petermcd1010/rhino_3d_models/arduino_base_xr2_xr2_unmounted.png

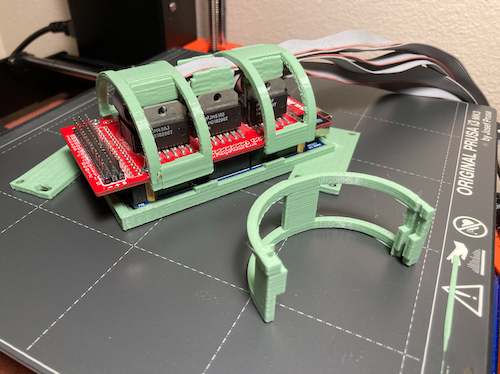
arduino_base_xr2_xr2_unmounted.png
