petermcd1010/rhino_3d_models/arduino_base_xr3_mounted.png

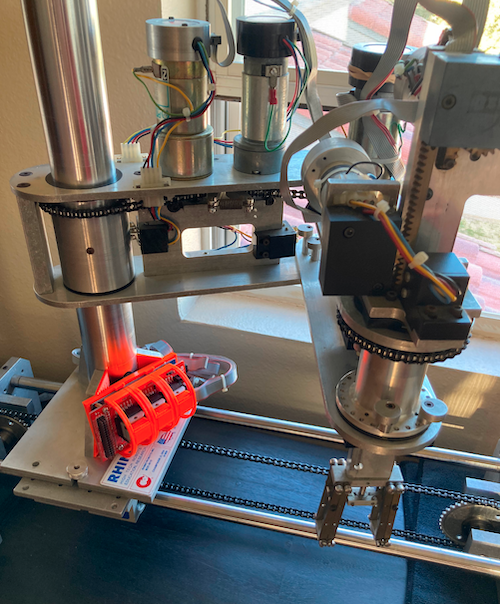
arduino_base_xr3_mounted.png
