petermcd1010/rhino_3d_models/rpi4_base_scara_with_tpu.stl

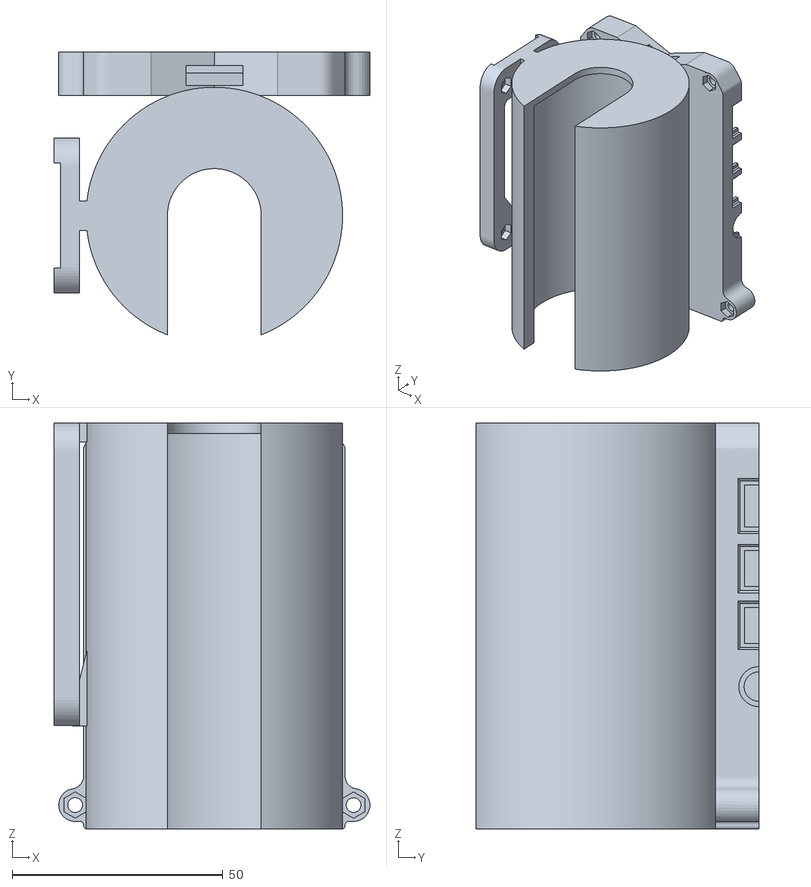
[picture p35: CAD file, 2023-12-21]
rpi4_base_scara_with_tpu.stl
74.9 x 67.0 x 96.2
