petermcd1010/rhino_3d_models/realsense_rhino_mount_plate_scara.stl

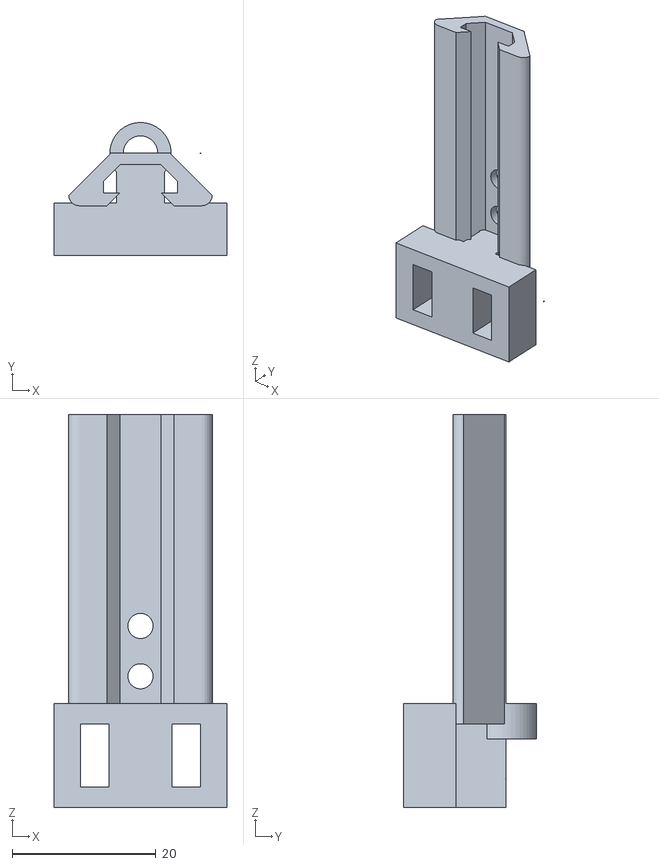
[picture p36: CAD file, 2023-12-14]
realsense_rhino_mount_plate_scara.stl
24.0 x 18.5 x 54.7
