petermcd1010/rhino_3d_models/realsense_rhino_mount_plate_xr1_spacer_plate.stl

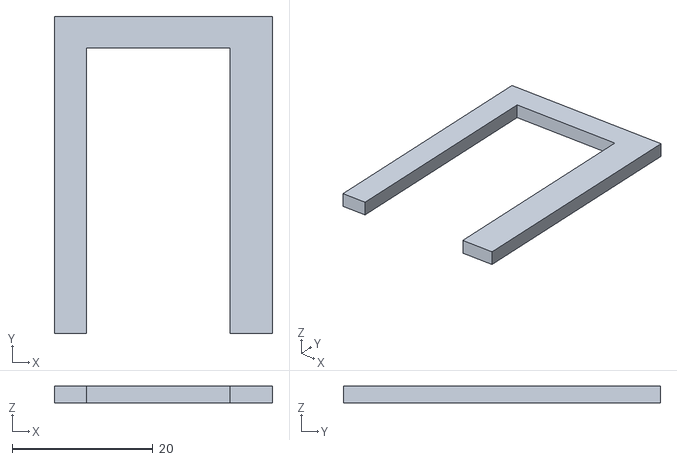
[picture p37: CAD file, 2023-11-25]
realsense_rhino_mount_plate_xr1_spacer_plate.stl
31.0 x 45.0 x 2.40
