petermcd1010/rhino_3d_models/realsense_rhino_mount_plate_xr1.stl

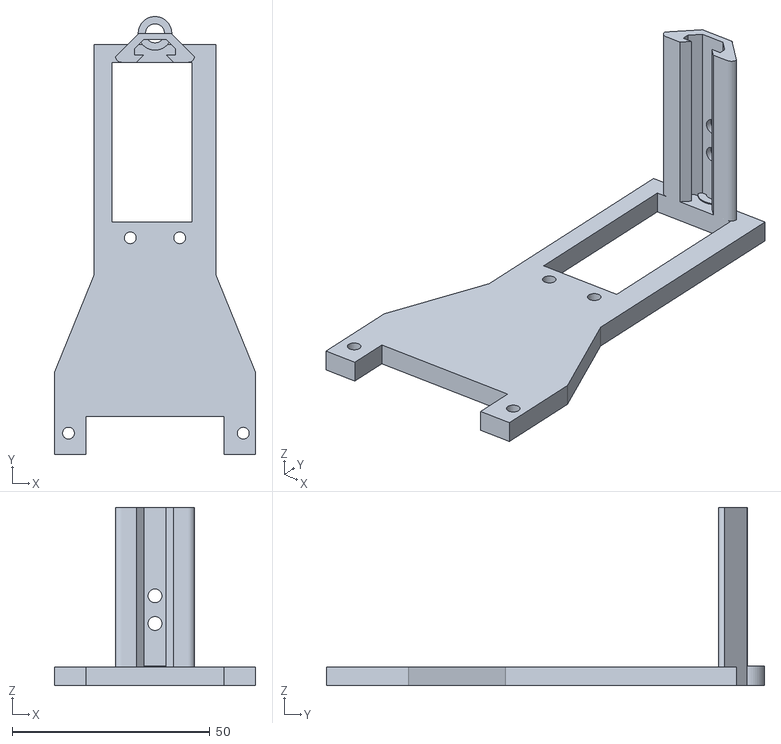
[picture p38: CAD file, 2023-11-25]
realsense_rhino_mount_plate_xr1.stl
51.0 x 110.9 x 45.2
