petermcd1010/rhino_3d_models/rpi4_base_xr4_with_tpu.stl

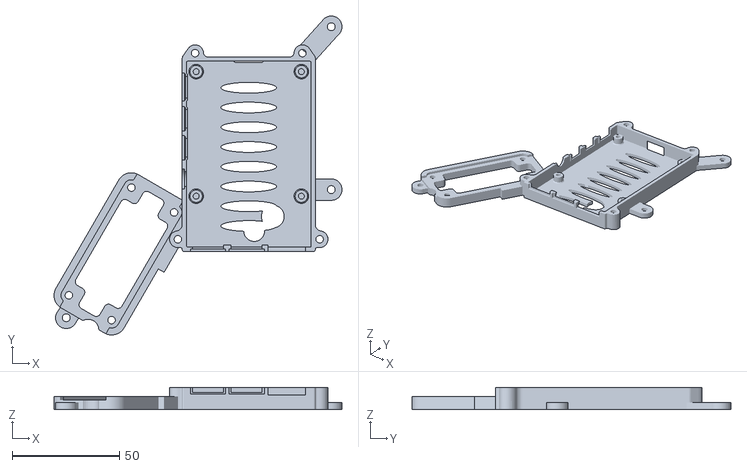
[picture p39: CAD file, 2023-10-29]
rpi4_base_xr4_with_tpu.stl
134.1 x 148.6 x 10.3
