petermcd1010/rhino_3d_models/realsense_rhino_mount_plate_xr2_xr3_xr4.stl

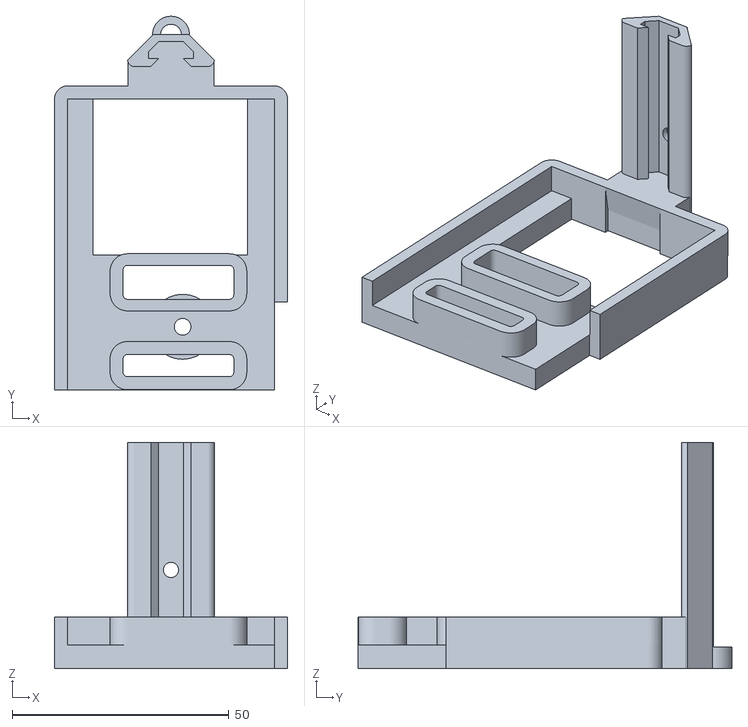
[picture p40: CAD file, 2023-10-28]
realsense_rhino_mount_plate_xr2_xr3_xr4.stl
53.7 x 86.1 x 52.2
