petermcd1010/rhino_3d_models/rpi4_base_xr2_xr3_with_tpu.stl

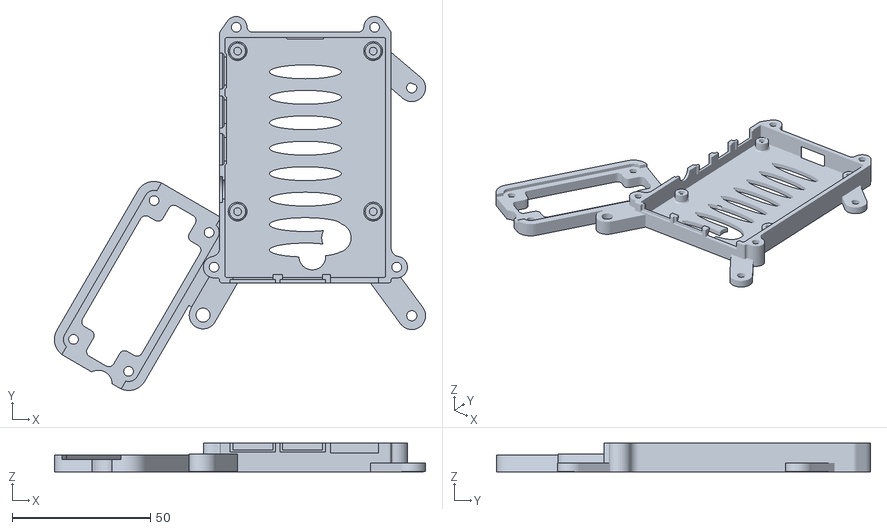
[picture p41: CAD file, 2023-10-24]
rpi4_base_xr2_xr3_with_tpu.stl
134.2 x 135.2 x 10.3
