petermcd1010/rhino_3d_models/realsense_stem.stl

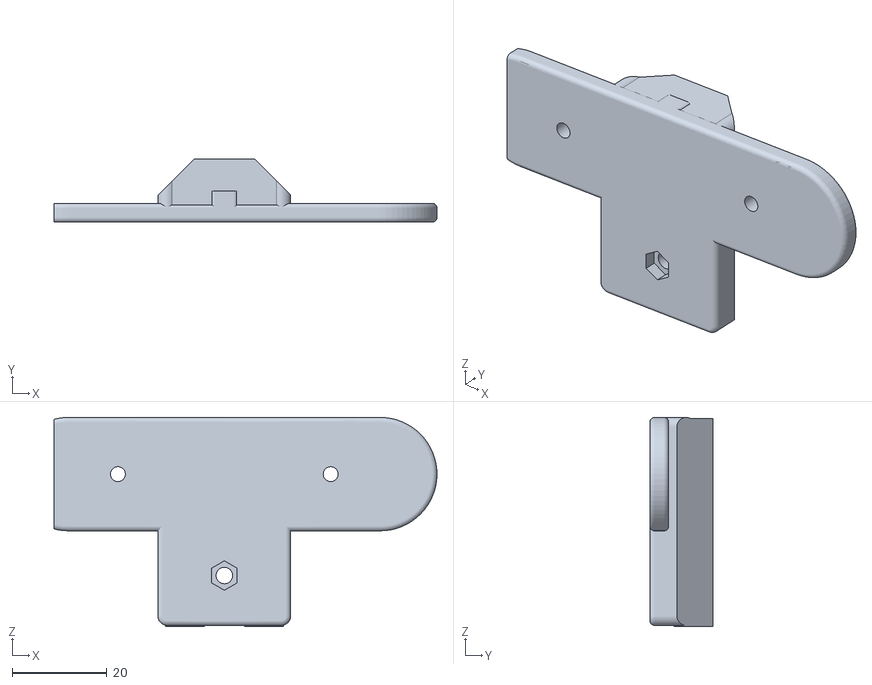
[picture p42: CAD file, 2023-09-17]
realsense_stem.stl
81.1 x 13.4 x 44.3
