petermcd1010/rhino_3d_models/rpi4_base_plain.stl

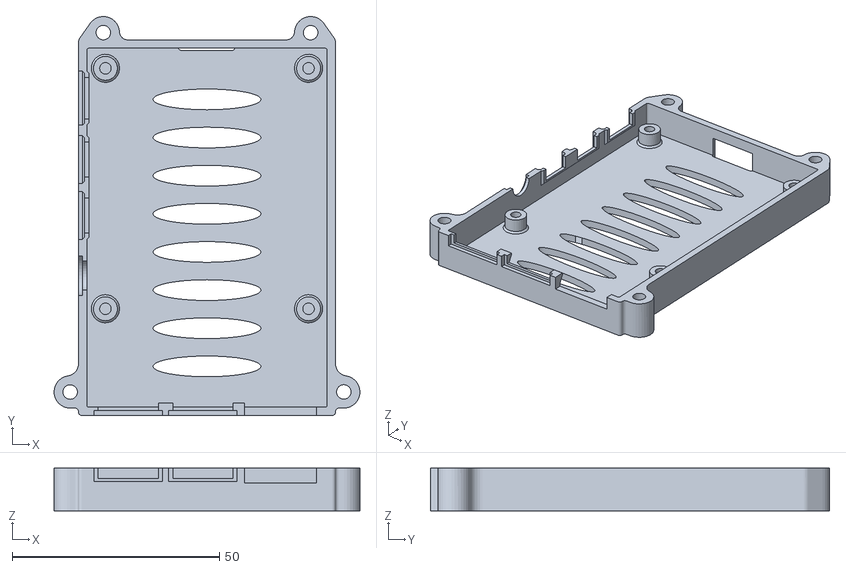
[picture p43: CAD file, 2023-08-26]
rpi4_base_plain.stl
73.8 x 96.2 x 10.3
