petermcd1010/rhino_3d_models/rpi4_spacer_pins.stl

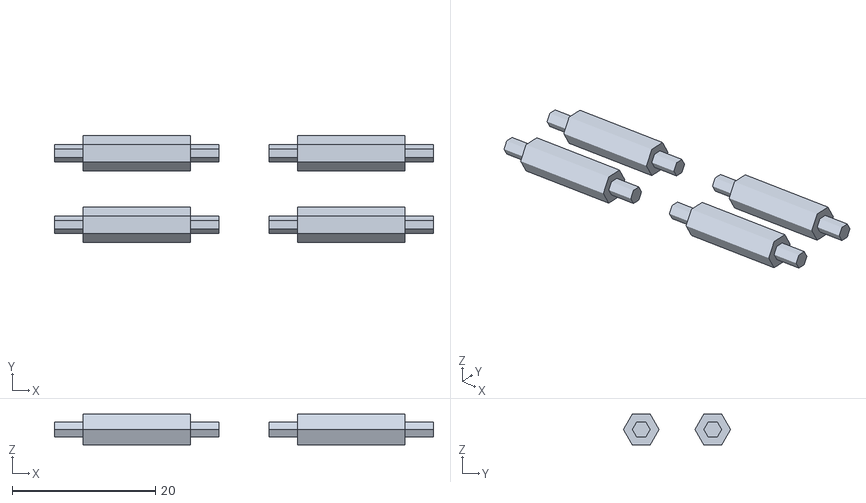
[picture p44: CAD file, 2023-08-26]
rpi4_spacer_pins.stl
53.0 x 15.0 x 4.33
