petermcd1010/rhino_3d_models/rpi4_base_xr1_with_tpu.stl

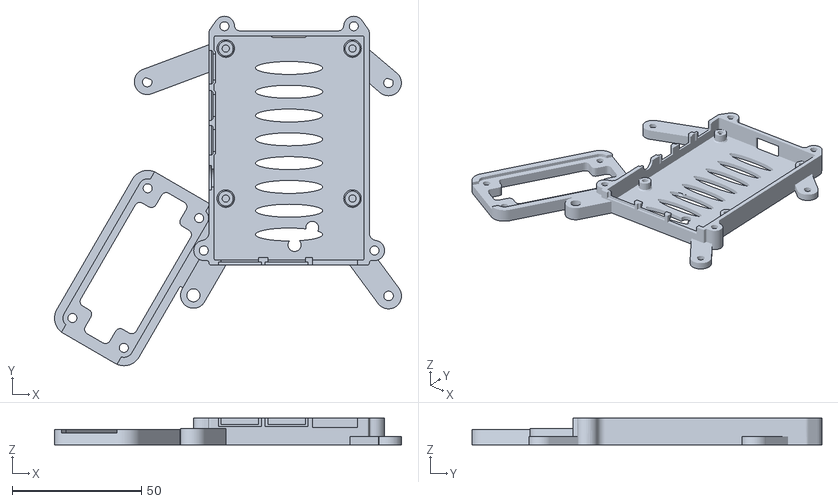
[picture p45: CAD file, 2023-08-26]
rpi4_base_xr1_with_tpu.stl
134.2 x 135.2 x 10.3
