petermcd1010/rhino_3d_models/rpi4_base_xr2_xr3.stl

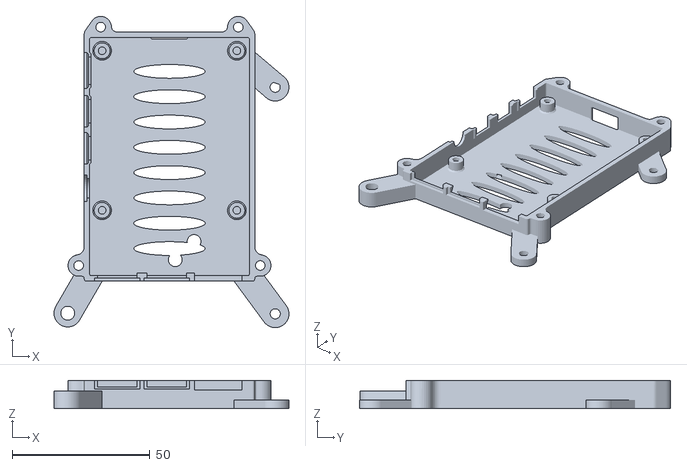
[picture p46: CAD file, 2023-08-26]
rpi4_base_xr2_xr3.stl
85.4 x 113.1 x 10.3
