petermcd1010/rhino_3d_models/rpi4_base_xr1.stl

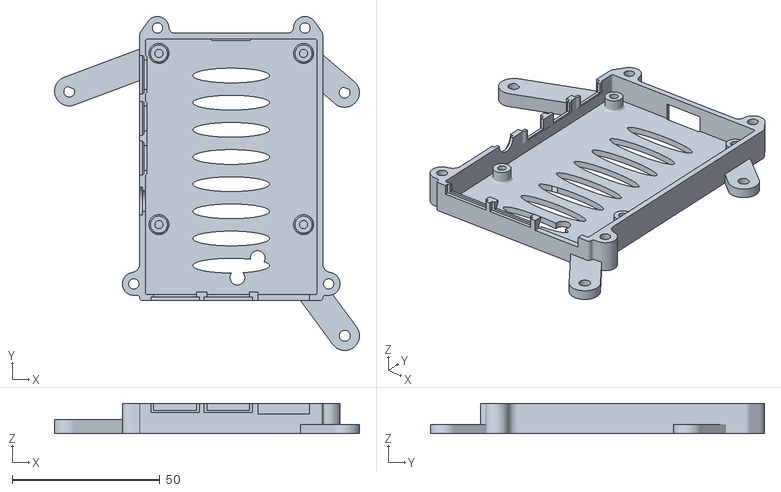
[picture p47: CAD file, 2023-08-26]
rpi4_base_xr1.stl
103.3 x 113.1 x 10.3
