petermcd1010/rhino_3d_models/rpi4_poe+_hat_top.stl

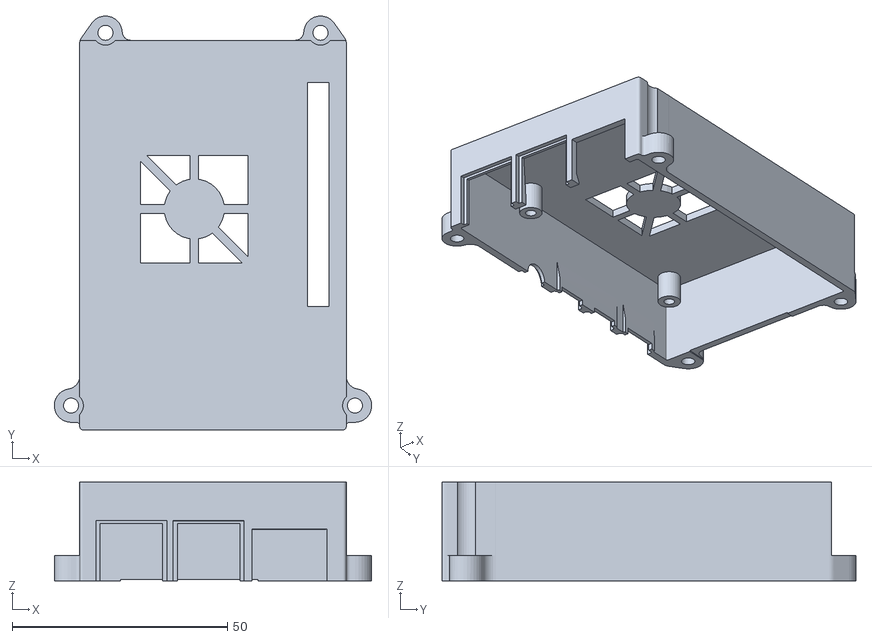
[picture p48: CAD file, 2023-08-26]
rpi4_poe+_hat_top.stl
73.8 x 96.2 x 23.0
