petermcd1010/rhino_3d_models/arduino_base_scara.stl

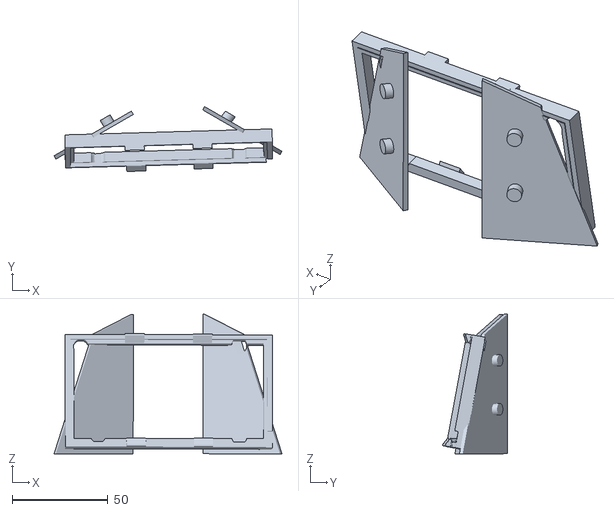
[picture p49: CAD file, 2023-04-05]
arduino_base_scara.stl
119.3 x 34.0 x 73.1
