petermcd1010/rhino_3d_models/arduino_base_xr4.stl

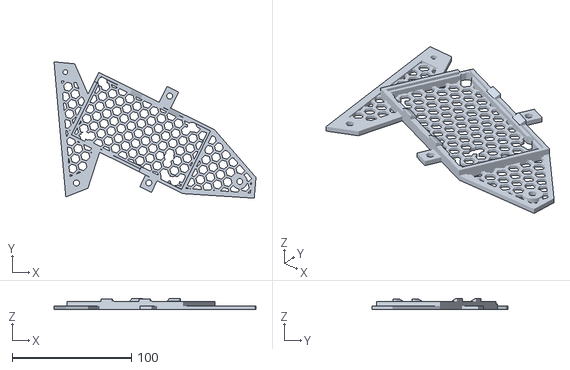
[picture p50: CAD file, 2023-03-11]
arduino_base_xr4.stl
169.2 x 114.2 x 9.46
