petermcd1010/rhino_3d_models/arduino_base_xr1.stl

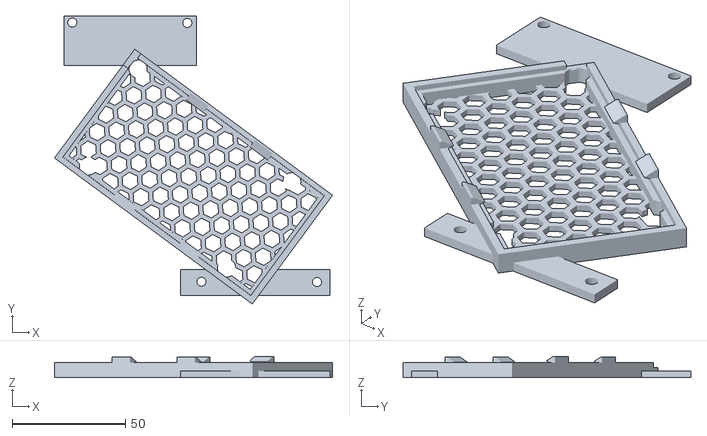
[picture p51: CAD file, 2023-03-05]
arduino_base_xr1.stl
122.7 x 127.1 x 9.46
