petermcd1010/rhino_3d_models/arduino_base_xr2_xr3.stl

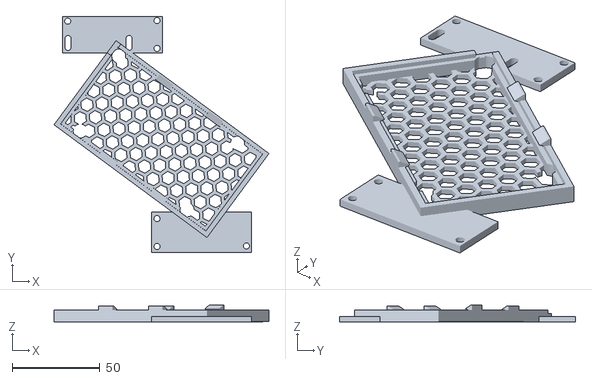
[picture p53: CAD file, 2023-03-05]
arduino_base_xr2_xr3.stl
122.7 x 134.9 x 9.46
