petermcd1010/rhino_3d_models/arduino_mm6_plug_not_xr1.stl

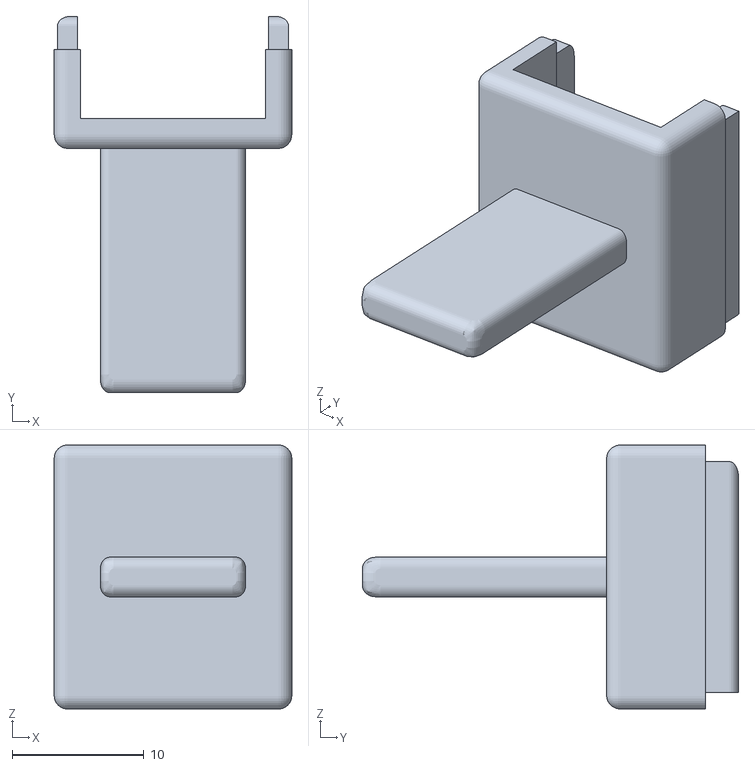
[picture p54: CAD file, 2023-03-05]
arduino_mm6_plug_not_xr1.stl
18.0 x 28.5 x 20.0
