petermcd1010/rhino_3d_models/arduino_mm6_arches.stl

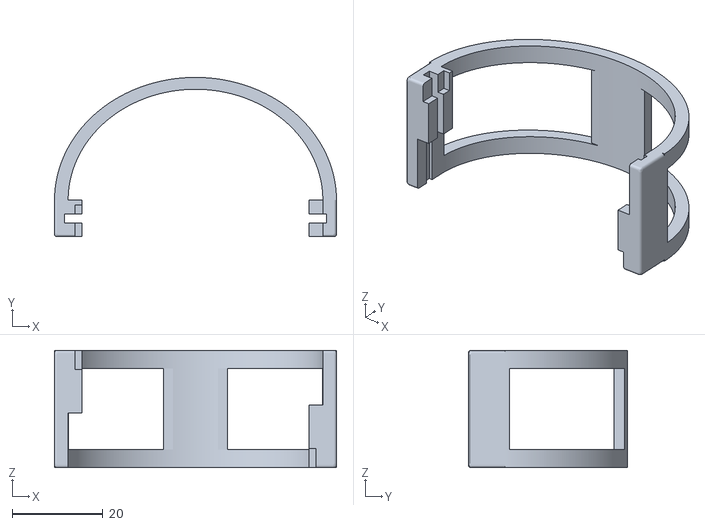
[picture p55: CAD file, 2023-02-25]
arduino_mm6_arches.stl
62.0 x 35.0 x 25.8
