petermcd1010/rhino_3d_models/(list of files, cad)

Other CAD files:
arduino_base.blend
arduino_mm6_arches_and_plug.blend
realsense.blend
rpi4_base.blend
rpi4_poe_hat_top.stl
