petermcd1010/rhino_3d_models/rpi4_base_xr2_xr3_with_tpu_printed.png

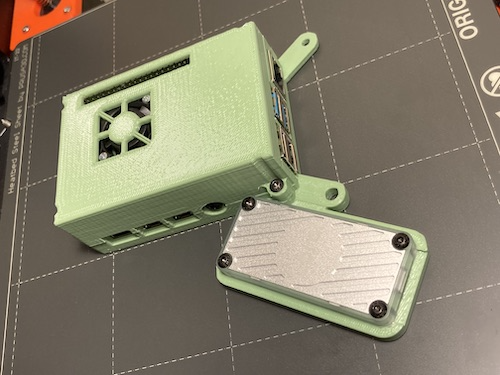
rpi4_base_xr2_xr3_with_tpu_printed.png
