petermcd1010/rhino_3d_models/(commit log)

2023-02-14 Add xr2_base_arduino_enclosure.{blend,stl}.
    [xr2_base_arduino_enclosure.blend, xr2_base_arduino_enclosure.stl]
2023-02-14 Rename models.
    [xr2_arduino_mount.blend, xr2_arduino_mount.stl]
2023-02-23 Add arduino_mm6_wire_clamp.* and xr2_arduino_mount.png.
    [arduino_mm6_wire_clamp.blend, arduino_mm6_wire_clamp_arches.stl, arduino_mm6_wire_clamp_plug.stl]
2023-02-25 Update arduino_wire_clamp* to latest revision.
    [arduino_mm6_wire_clamp.blend, arduino_mm6_wire_clamp_arches.stl, arduino_mm6_wire_clamp_plug.stl]
2023-03-05 Add files for rhino xr1 arm and update file names to support multiple arm types.
    [arduino_base.blend, arduino_base_xr1.stl, arduino_base_xr2.stl, arduino_mm6_arches.stl, arduino_mm6_arches_and_plug.blend, arduino_mm6_plug_not_xr1.stl, arduino_mm6_plug_xr1.stl, arduino_mm6_wire_clamp.blend]
2023-03-06 Remove xr2_arduino_mount.stl.
    [xr2_arduino_mount.stl]
2023-03-11 Add arduino mount plate and alignment images for xr1, xr2, and xr4.
    [arduino_base.blend, arduino_mm6_arches_and_plug.blend]
2023-03-11 Add arduino_base_xr4.stl.
    [arduino_base_xr4.stl]
2023-04-05 Add Rhino Robots SCARA arm mount.
    [arduino_base.blend, arduino_base_scara.stl, arduino_mm6_arches_and_plug.blend]
2023-04-13 Add arduino mount photos.
2023-08-26 Add Raspberry Pi 4 enclosures for XR-1, XR-2, (and reference enclosure) as well as spacer pins.
    [rpi4_base_plain.stl, rpi4_base_xr1.stl, rpi4_base_xr1_with_tpu.stl, rpi4_base_xr2.stl, rpi4_base_xr2_with_tpu.stl, rpi4_poe+_hat_top.stl, rpi4_poe_hat_top.stl, rpi4_spacer_pins.stl]
2023-08-26 Add rp4 xr2 protos and m3 nut insertion instructions.
2023-09-17 Add realsense mount for XR-2 and XR-4.
    [realsense.blend, realsense_rhino_mount_plate_xr2_xr4.stl, realsense_stem.stl]
2023-09-17 Update README.md
    Update README.md for Realsense mount for XR-2 and XR-4.
2023-10-24 Update for XR-3.
    [arduino_base_xr2_xr3.stl, rpi4_base.blend, rpi4_base_xr2_with_tpu.stl, rpi4_base_xr2_xr3.stl, rpi4_base_xr2_xr3_with_tpu.stl]
2023-10-24 Update README.md to change Arduino XR-2 to Arduino XR-2 and XR-3.
2023-10-28 Update Realsense Rhino Mount plate for standard size #6 hex nuts.
    [realsense.blend, realsense_rhino_mount_plate_xr2_xr3_xr4.stl, realsense_rhino_mount_plate_xr2_xr4.stl]
2023-10-28 Update README.md to clarify that Realsense mount is for XR-2, XR-3, and XR-4.
2023-10-29 Add rpi4 base for xr4 with tpu.
    [rpi4_base.blend, rpi4_base_xr4_with_tpu.stl]
2023-10-29 Update README.md XR-4 RPI mount fasteners.
2023-11-25 Add realsense_rhino_mount_plate*{png,stl} and updated realsense.blend.
    [realsense.blend, realsense_rhino_mount_plate_xr1.stl, realsense_rhino_mount_plate_xr1_spacer_plate.stl]
2023-12-14 Update for SCARA realsense mount.
    [realsense.blend, realsense_rhino_mount_plate_scara.stl, rpi4_base.blend]
2023-12-21 Add Raspberry Pi 4 and TPU mount for SCARA arm.
    [realsense.blend, rpi4_base.blend, rpi4_base_scara.stl]
2023-12-21 Fix scara stl path.
    [rpi4_base_scara_with_tpu.stl]
